rvi007/welding-robot/docs/images/closeup.png

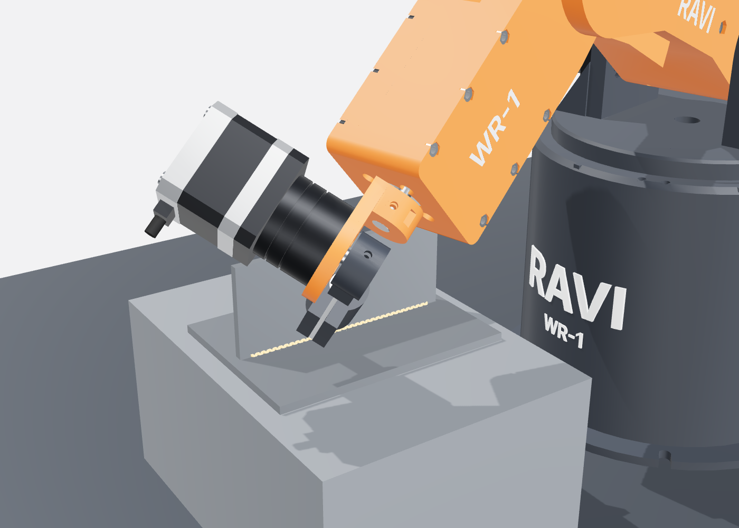
docs/images/closeup.png
