rvi007/welding-robot/docs/images/fillet_straight.png

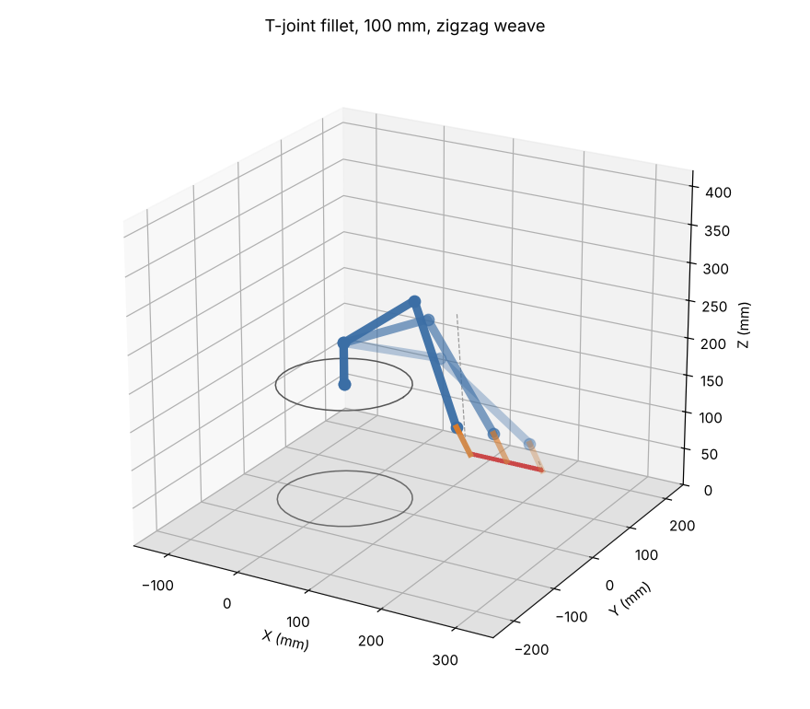
docs/images/fillet_straight.png
