rvi007/welding-robot/docs/images/front.png

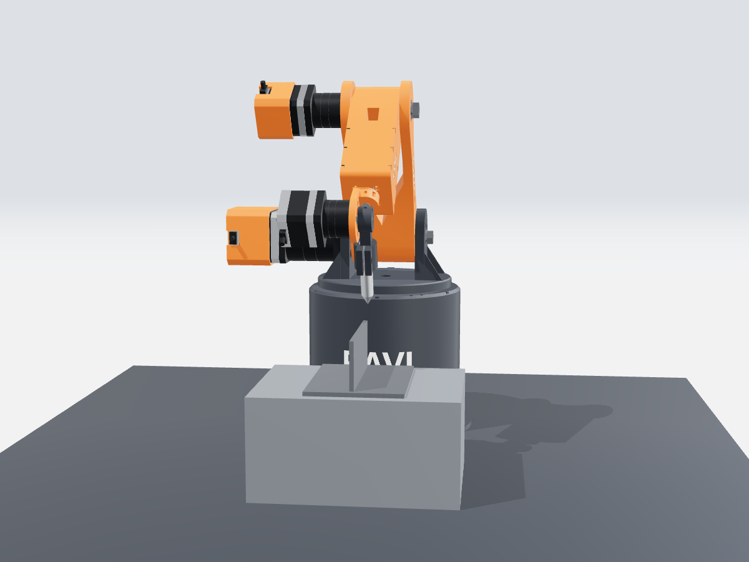
docs/images/front.png
