rvi007/welding-robot/docs/images/ready.png

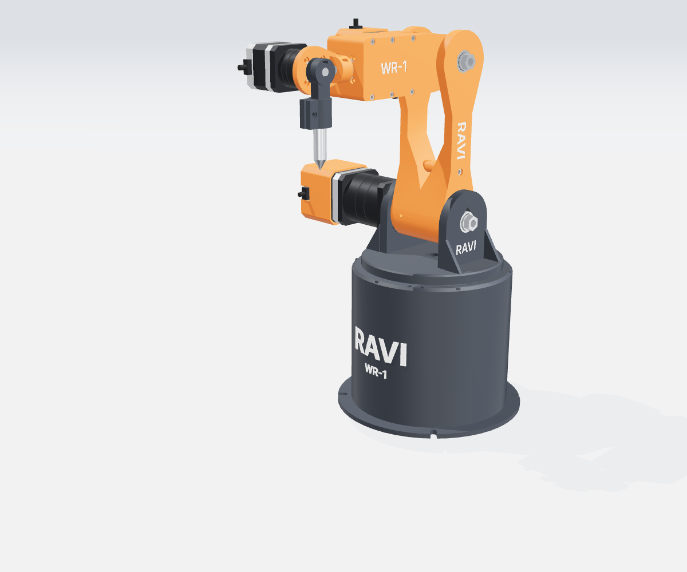
docs/images/ready.png
