rvi007/welding-robot/docs/images/side.png

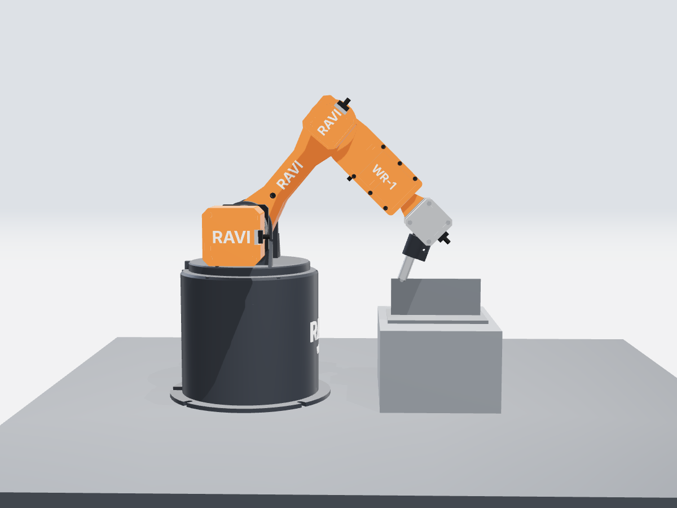
docs/images/side.png
