rvi007/welding-robot/docs/bom.csv

category | qty | part | used_for | approx_usd
motion | 2 | NEMA17 48mm 1.68A stepper + 26.85:1 planetary gearbox, 8mm D-shaft (e.g. StepperOnline 17HS19-1684S-PG27) | J1 base, J3 elbow | 70
motion | 2 | NEMA17 34mm stepper + 5.18:1 planetary gearbox, 8mm D-shaft (e.g. StepperOnline 17HS13-0404S-PG5) | J4 roll, J5 wrist | 55
motion | 1 | NEMA23 56mm 2.8A stepper + 10:1 planetary gearbox, 14mm keyed shaft, bought as one unit | J2 shoulder | 80
motion | 2 | 6008-2RS bearing 40x68x15 | J1 turntable | 10
motion | 4 | 608-2RS bearing 8x22x7 | J2/J3 idle pivots (2 spare) | 4
electronics | 1 | Arduino Mega 2560 | controller | 18
electronics | 1 | RAMPS 1.4 | controller shield | 8
electronics | 4 | TMC2209 step/dir driver | J1, J3, J4, J5 | 20
electronics | 1 | DM542T stepper driver | J2 | 30
electronics | 1 | 12V 15A power supply | RAMPS | 25
electronics | 1 | 24-36V 5A power supply | DM542T | 22
electronics | 5 | KW11 / SS-5GL lever microswitch | homing | 6
electronics | 1 | 12V relay module | arc output (D10) | 4
electronics | 1 | Mushroom E-stop, 2x NC | safety | 10
electronics | 1 | Mains inlet with switch and fuse | power | 6
electronics | 1 | Cables, ferrites, connectors, spiral wrap | wiring | 30
hardware | 20 | M3 heat-set insert | printed parts | 8
hardware | 1 | Screw kit: M2, M3, M4, M5 button/socket/countersunk, M8x50, M8x45, nuts, washers, set screws | assembly | 25
printing | 1 | PETG filament 1kg orange | arm, covers | 20
printing | 1 | PETG filament 1kg graphite/black | base, turntable, small parts | 20
printing | 1 | White paint pen | RAVI lettering | 4
tool | 1 | 12mm pointer rod or laser module | calibration | 5
tool | 1 | Marker refill + 12mm sleeve | pen tests | 2
