rvi007/welding-robot/docs/images/parts/upper_arm_drive.png

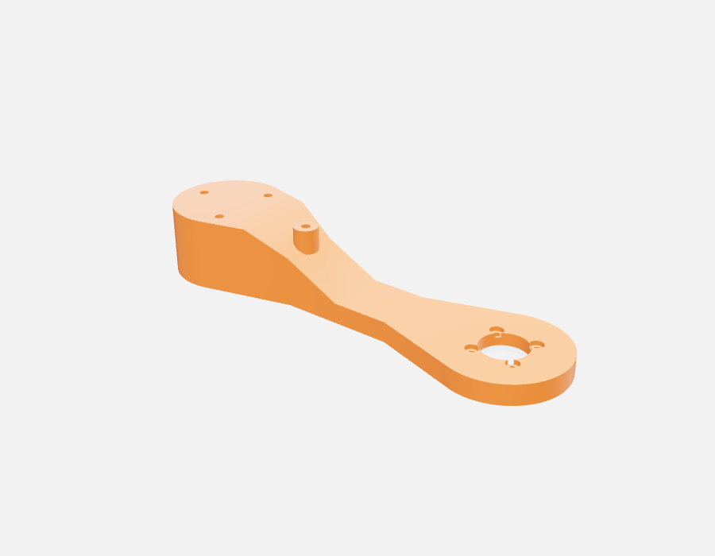
docs/images/parts/upper_arm_drive.png
