rvi007/welding-robot/docs/viewer/models/L1_black.stl

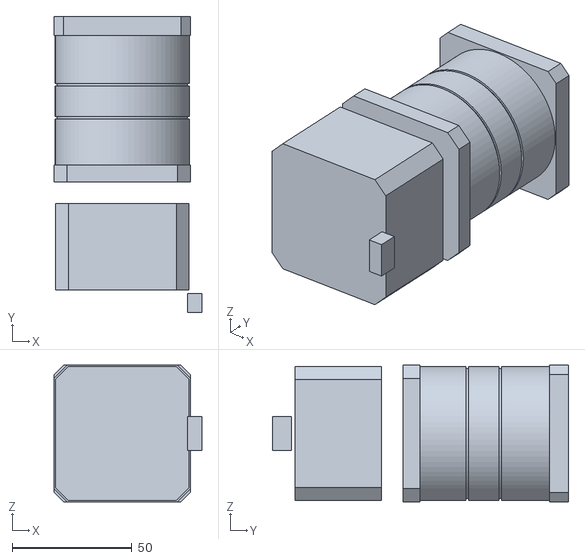
[picture p29: CAD file, 2026-10-21]
docs/viewer/models/L1_black.stl
61.7 x 123.5 x 57.0
