rvi007/welding-robot/docs/viewer/models/C_gm17_34_logo.stl

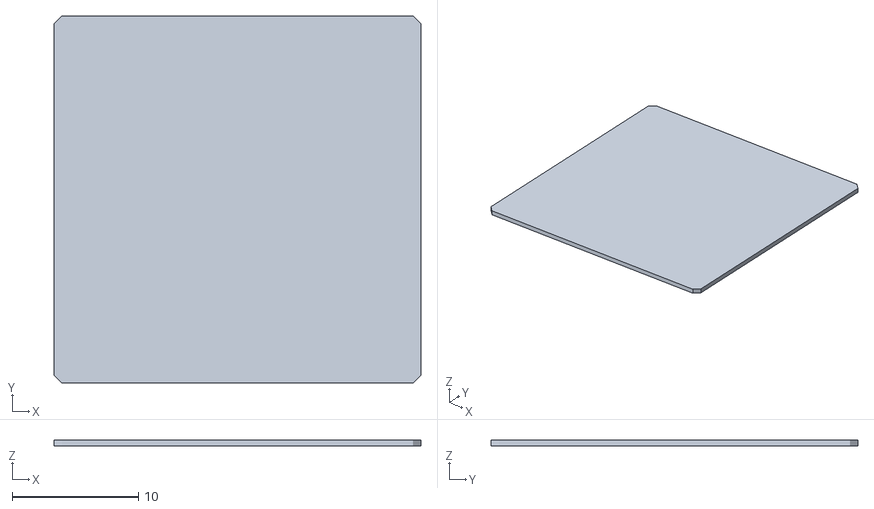
[picture p31: CAD file, 2026-10-21]
docs/viewer/models/C_gm17_34_logo.stl
29.1 x 29.1 x 0.5
