rvi007/welding-robot/stl/j1_motor_mount.stl

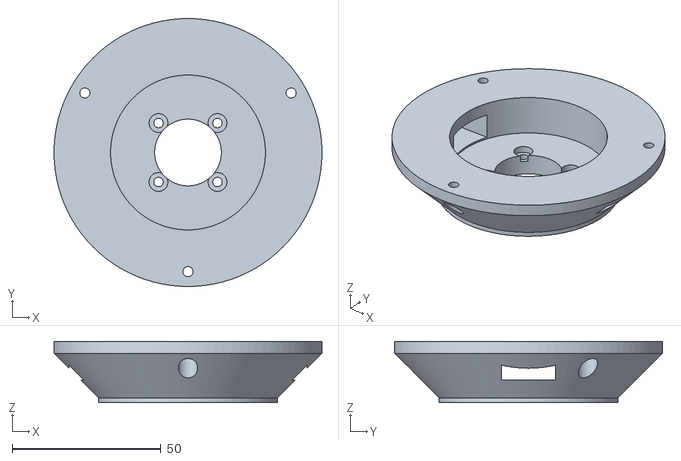
[picture p32: CAD file, 2026-10-21]
stl/j1_motor_mount.stl
90.0 x 90.0 x 20.5
