rvi007/welding-robot/docs/viewer/models/C_gm23_56_steel.stl

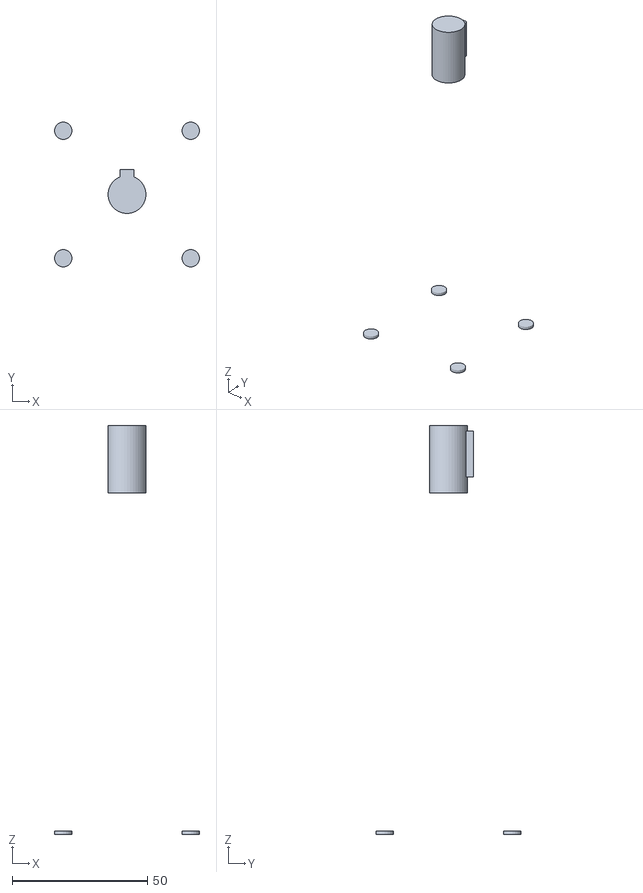
[picture p33: CAD file, 2026-10-21]
docs/viewer/models/C_gm23_56_steel.stl
53.6 x 53.6 x 151.2
