rvi007/welding-robot/stl/j1_collar.stl

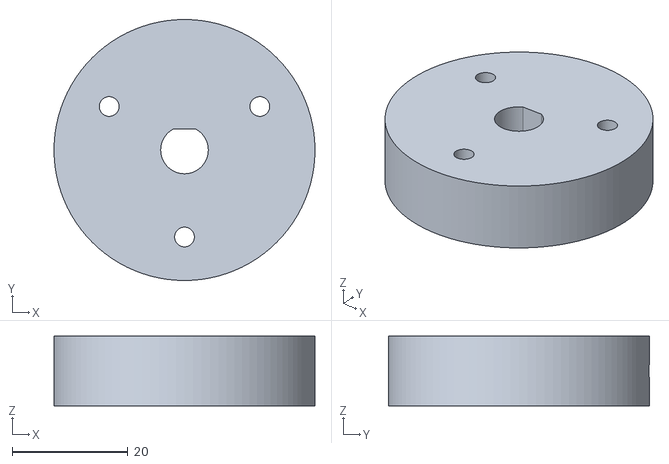
[picture p34: CAD file, 2026-10-21]
stl/j1_collar.stl
45.0 x 45.0 x 12.0
