rvi007/welding-robot/docs/viewer/models/L4_alu.stl

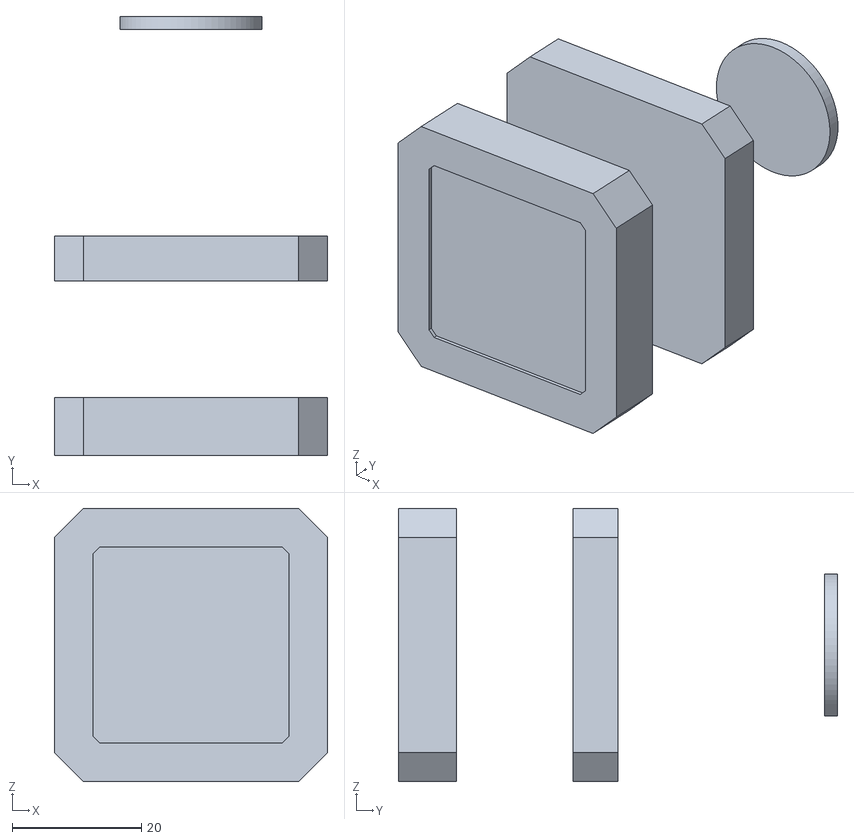
[picture p35: CAD file, 2026-10-21]
docs/viewer/models/L4_alu.stl
42.3 x 68.0 x 42.3
