rvi007/welding-robot/stl/wrist.stl

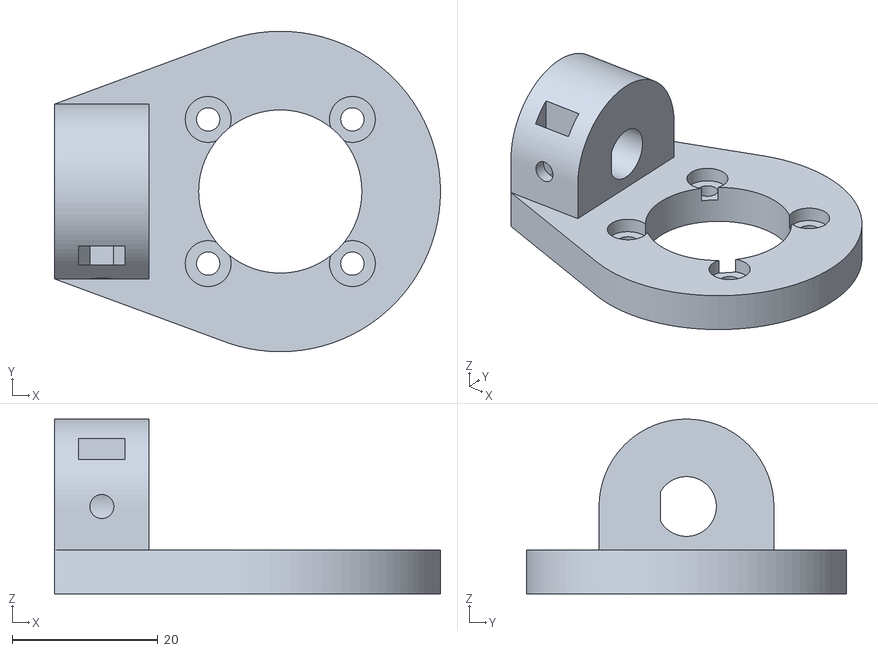
[picture p36: CAD file, 2026-10-21]
stl/wrist.stl
53.0 x 44.0 x 24.0
