rvi007/welding-robot/docs/viewer/models/C_gm17_48_rubber.stl

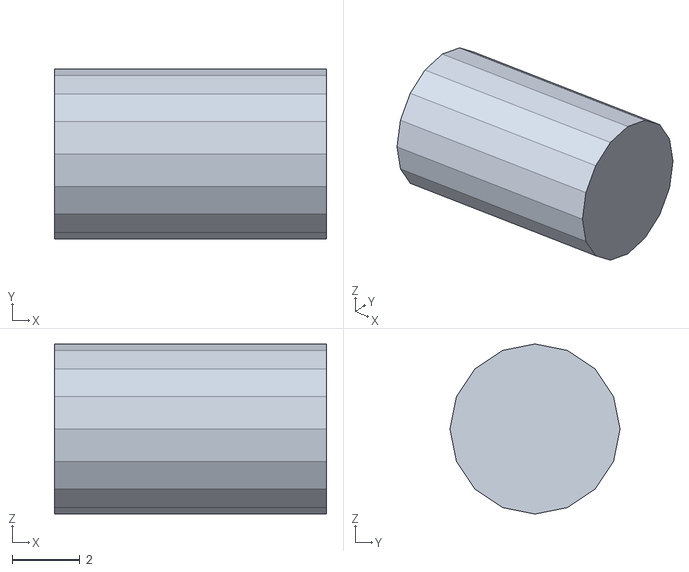
[picture p37: CAD file, 2026-10-21]
docs/viewer/models/C_gm17_48_rubber.stl
8.00 x 5.00 x 5.00
