rvi007/welding-robot/stl/j2_cover.stl

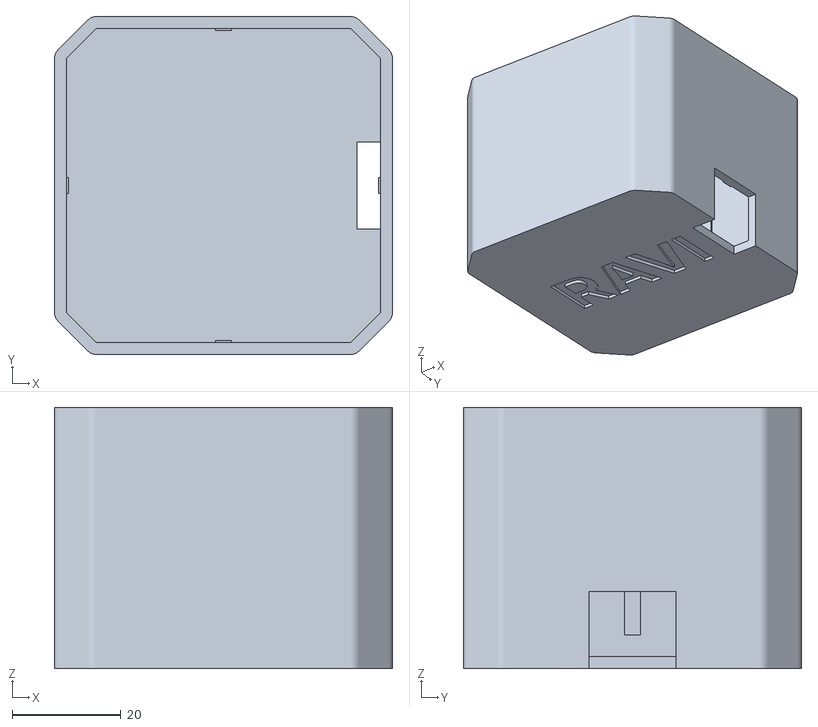
[picture p38: CAD file, 2026-10-21]
stl/j2_cover.stl
62.1 x 62.1 x 48.0
