rvi007/welding-robot/docs/viewer/models/L6_table.stl

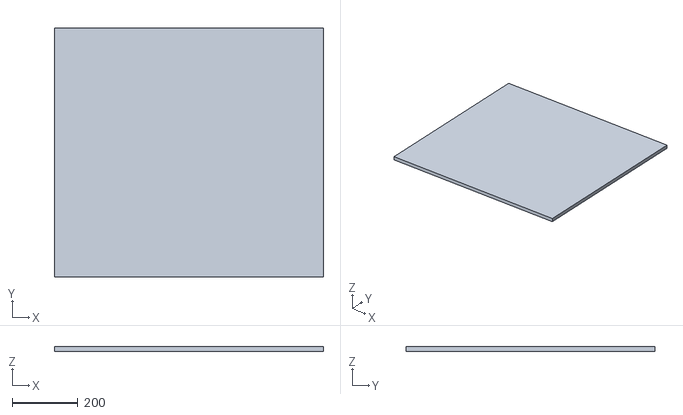
[picture p39: CAD file, 2026-10-21]
docs/viewer/models/L6_table.stl
820.0 x 760.0 x 15.0
