rvi007/welding-robot/stl/endstop_clip.stl

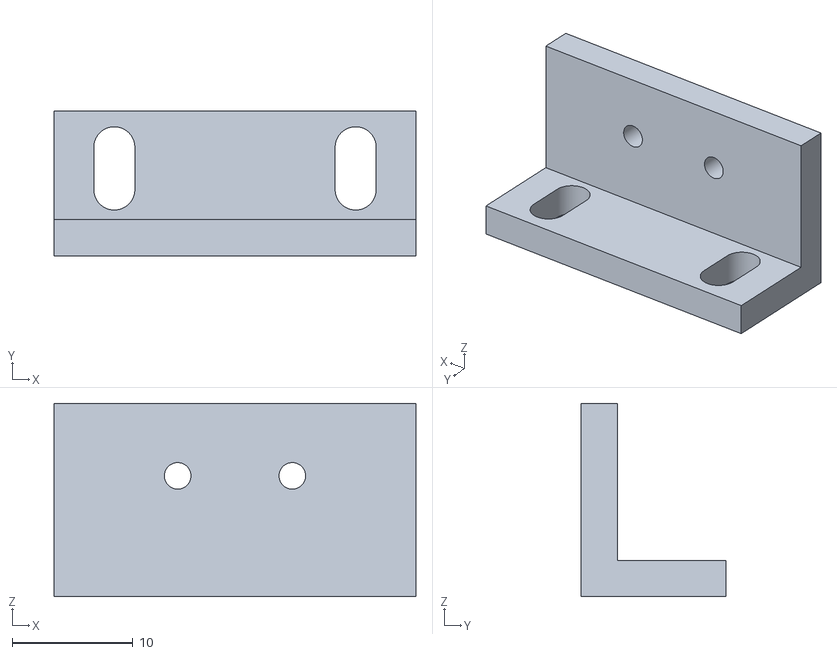
[picture p40: CAD file, 2026-10-21]
stl/endstop_clip.stl
30.0 x 12.0 x 16.0
