rvi007/welding-robot/docs/viewer/models/L5_printed2.stl

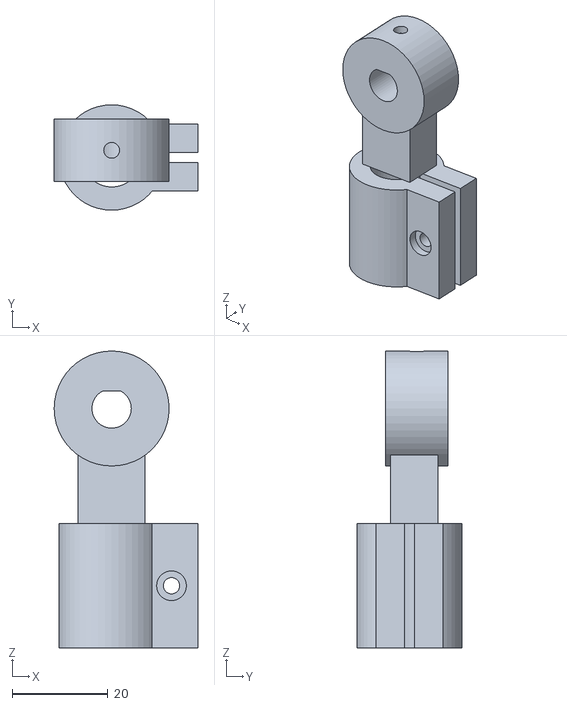
[picture p41: CAD file, 2026-10-21]
docs/viewer/models/L5_printed2.stl
30.0 x 22.0 x 62.0
