rvi007/welding-robot/stl/base_shell.stl

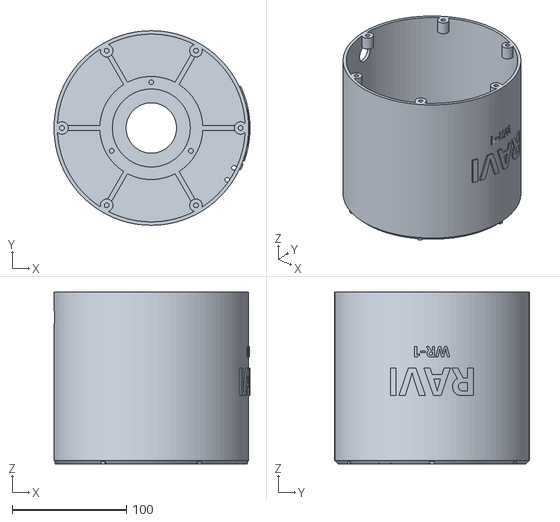
[picture p42: CAD file, 2026-10-21]
stl/base_shell.stl
171.2 x 170.0 x 150.0
