rvi007/welding-robot/stl/upper_arm_drive.stl

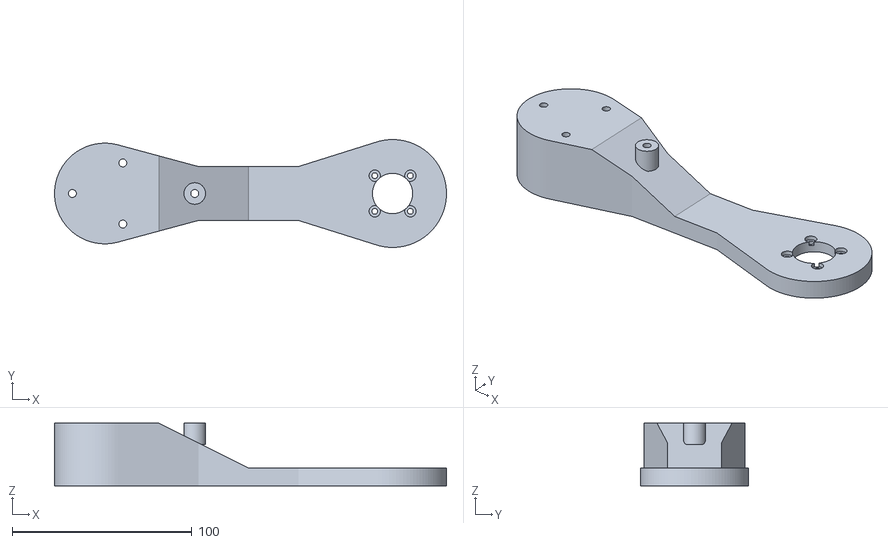
[picture p43: CAD file, 2026-10-21]
stl/upper_arm_drive.stl
218.0 x 60.0 x 35.0
