rvi007/welding-robot/docs/viewer/models/L0_rubber.stl

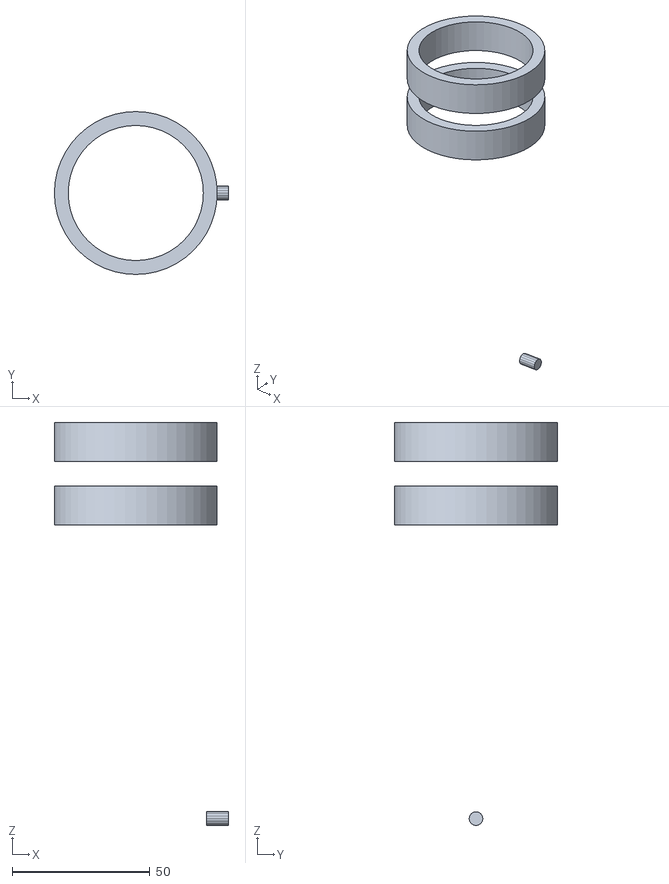
[picture p44: CAD file, 2026-10-21]
docs/viewer/models/L0_rubber.stl
63.2 x 59.0 x 146.1
