rvi007/welding-robot/stl/j3_cover.stl

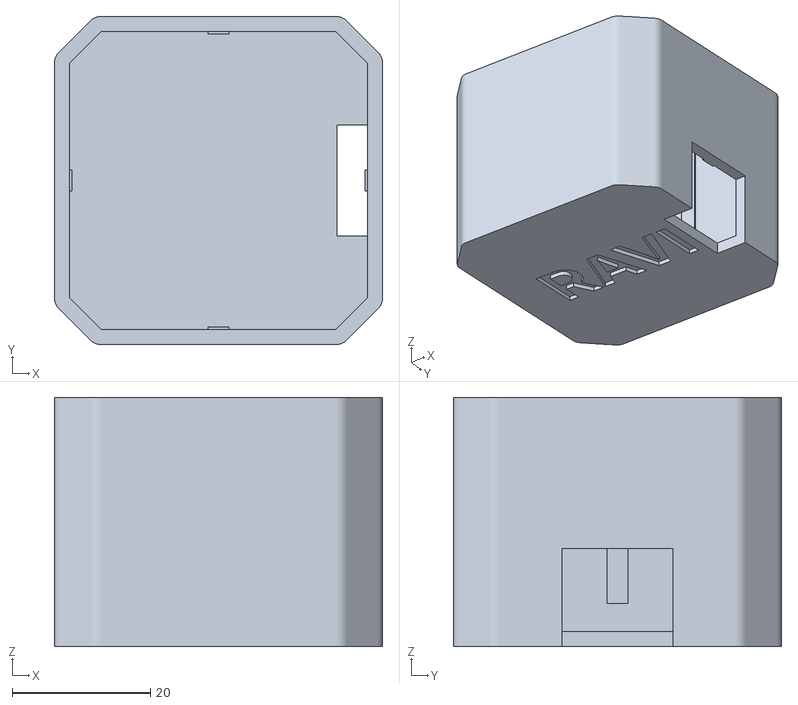
[picture p45: CAD file, 2026-10-21]
stl/j3_cover.stl
47.4 x 47.4 x 36.0
