rvi007/welding-robot/docs/viewer/models/L1_steel.stl

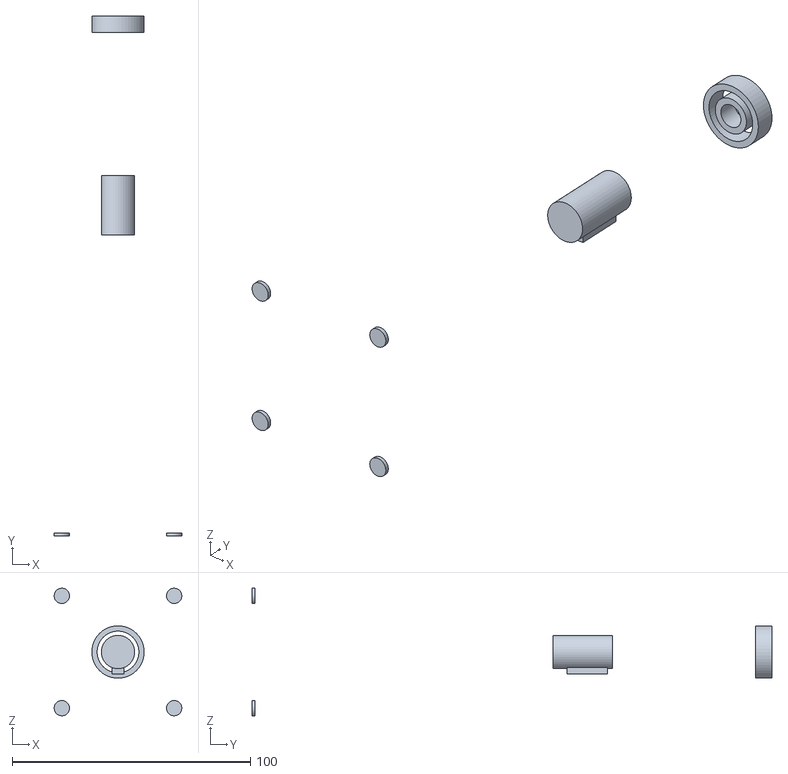
[picture p46: CAD file, 2026-10-21]
docs/viewer/models/L1_steel.stl
53.6 x 218.2 x 53.6
