rvi007/welding-robot/stl/turntable.stl

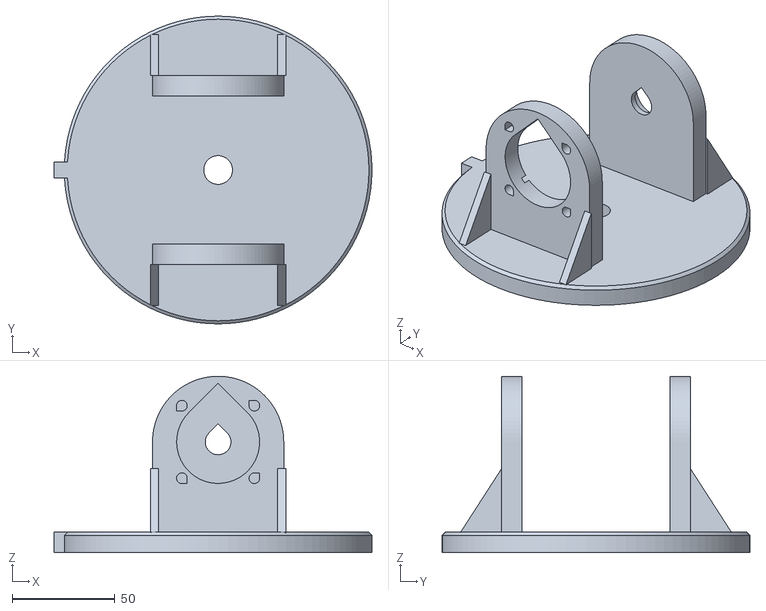
[picture p47: CAD file, 2026-10-21]
stl/turntable.stl
155.0 x 150.0 x 86.0
