rvi007/welding-robot/docs/viewer/models/C_b6008_steel.stl

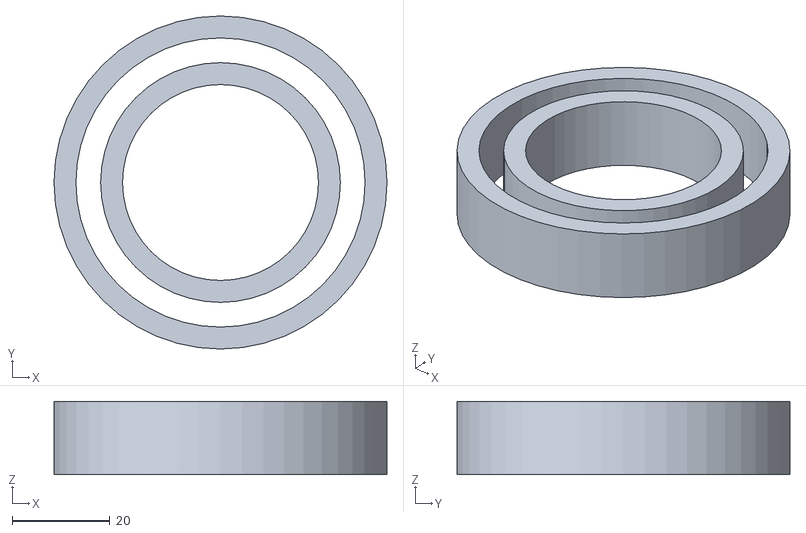
[picture p48: CAD file, 2026-10-21]
docs/viewer/models/C_b6008_steel.stl
68.0 x 68.0 x 15.0
