rvi007/welding-robot/stl/j1_spigot.stl

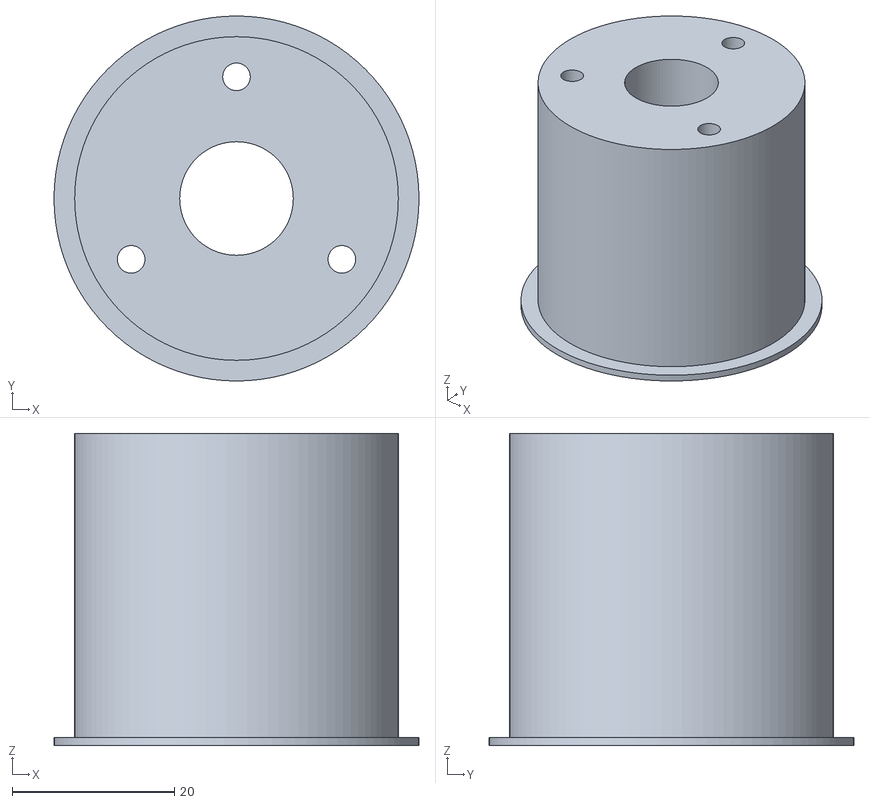
[picture p49: CAD file, 2026-10-21]
stl/j1_spigot.stl
45.0 x 45.0 x 38.5
