rvi007/welding-robot/stl/base_floor.stl

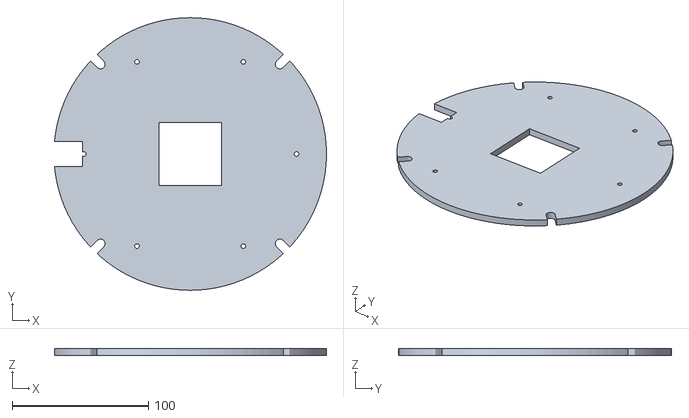
[picture p50: CAD file, 2026-10-21]
stl/base_floor.stl
199.5 x 200.0 x 5.00
