rvi007/welding-robot/stl/fit_test.stl

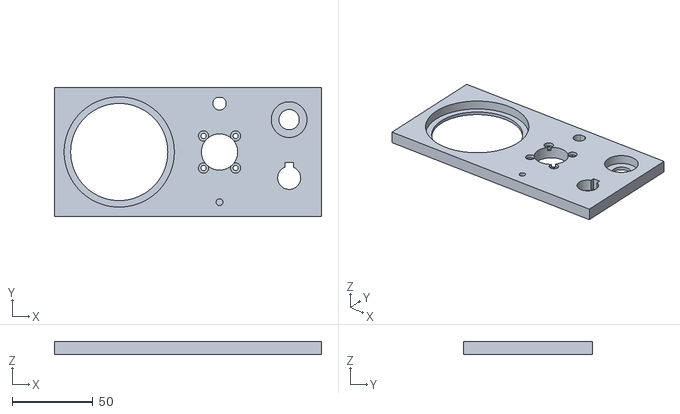
[picture p51: CAD file, 2026-10-21]
stl/fit_test.stl
165.0 x 80.0 x 8.00
