rvi007/welding-robot/docs/viewer/models/L3_printed.stl

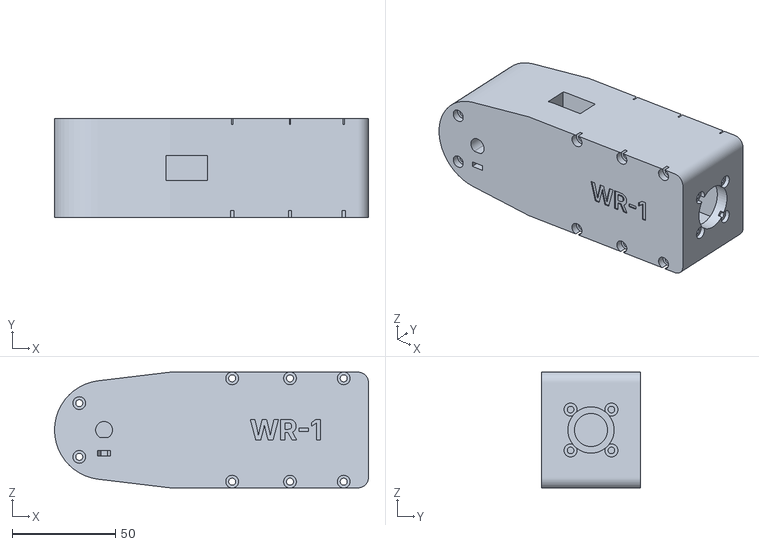
[picture p52: CAD file, 2026-10-21]
docs/viewer/models/L3_printed.stl
152.0 x 48.0 x 56.0
