rvi007/welding-robot/docs/viewer/models/L0_alu.stl

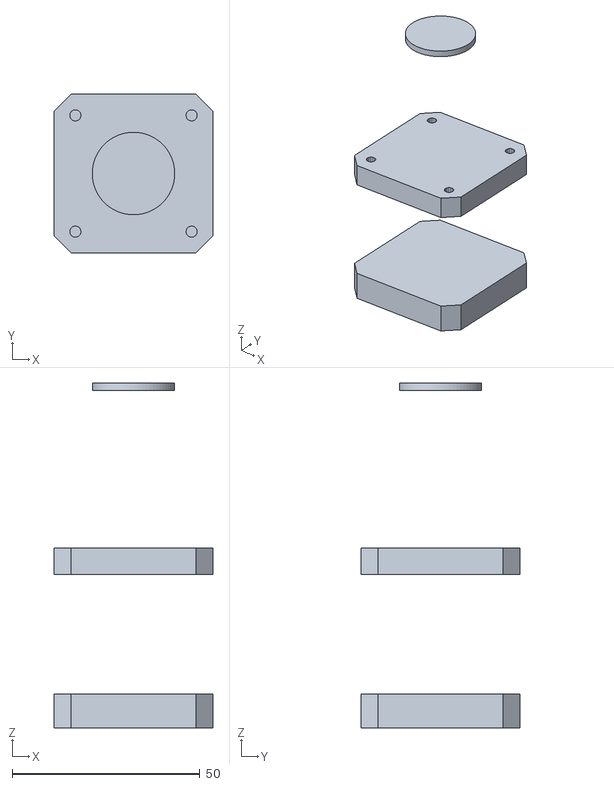
[picture p53: CAD file, 2026-10-21]
docs/viewer/models/L0_alu.stl
42.3 x 42.3 x 92.0
