rvi007/welding-robot/stl/forearm_drive.stl

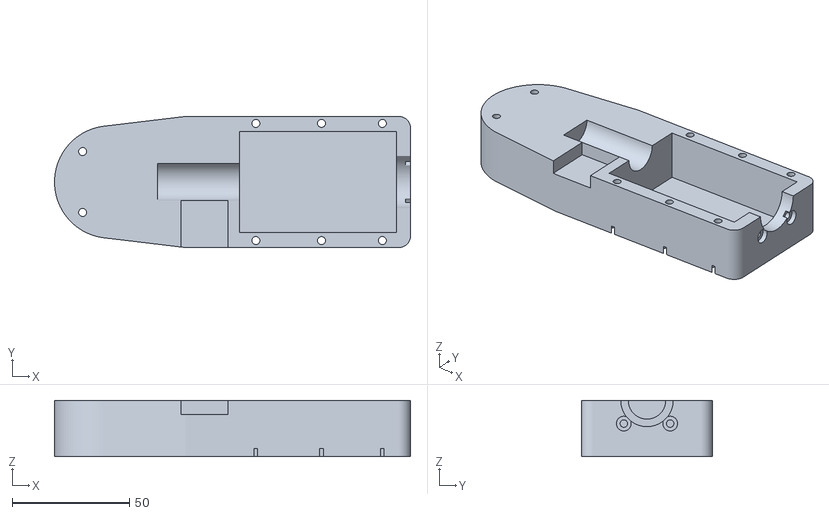
[picture p54: CAD file, 2026-10-21]
stl/forearm_drive.stl
152.0 x 56.0 x 24.0
