rvi007/welding-robot/docs/viewer/models/C_gm17_34_steel.stl

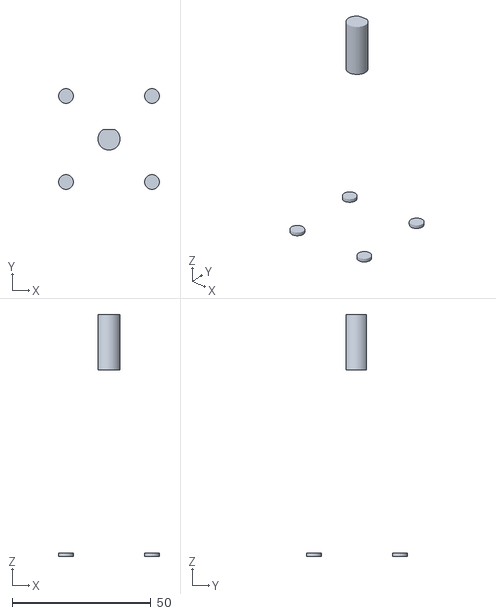
[picture p55: CAD file, 2026-10-21]
docs/viewer/models/C_gm17_34_steel.stl
36.4 x 36.4 x 87.2
