rvi007/welding-robot/docs/viewer/models/C_gm23_56_logo.stl

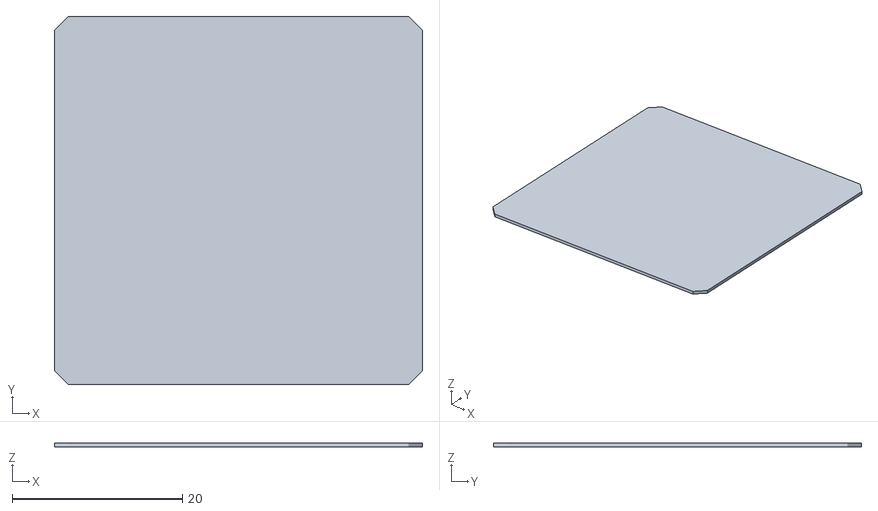
[picture p56: CAD file, 2026-10-21]
docs/viewer/models/C_gm23_56_logo.stl
43.2 x 43.2 x 0.5
