rvi007/welding-robot/stl/spacer_m8.stl

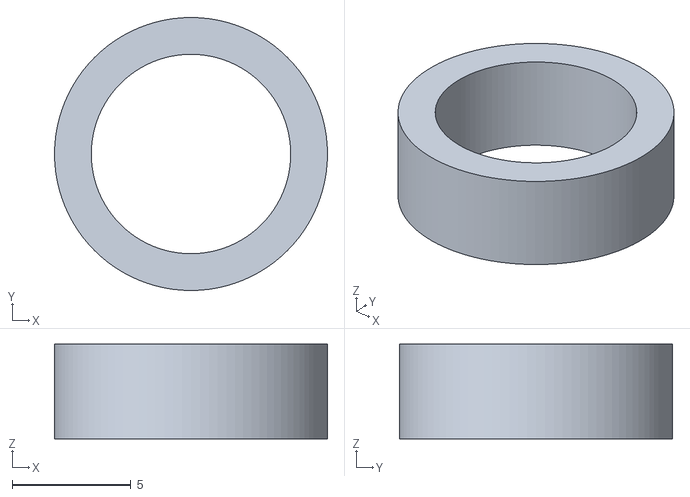
[picture p57: CAD file, 2026-10-21]
stl/spacer_m8.stl
11.5 x 11.5 x 4.00
