rvi007/welding-robot/docs/viewer/models/L3_black.stl

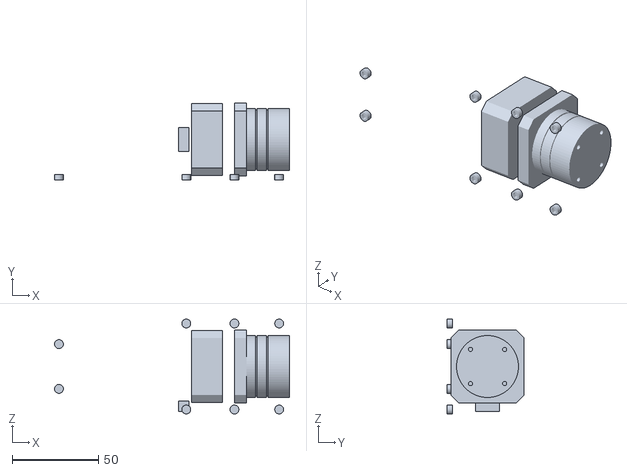
[picture p58: CAD file, 2026-10-21]
docs/viewer/models/L3_black.stl
136.6 x 44.6 x 55.2
