rvi007/welding-robot/docs/viewer/models/L2_steel.stl

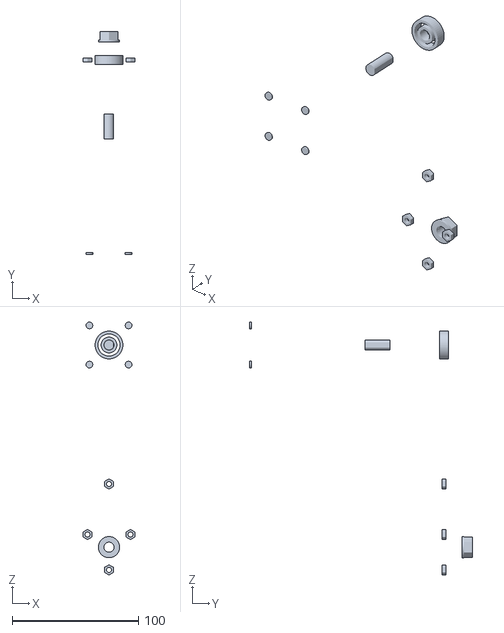
[picture p59: CAD file, 2026-10-21]
docs/viewer/models/L2_steel.stl
41.0 x 176.2 x 200.2
