rvi007/welding-robot/docs/viewer/models/L4_black.stl

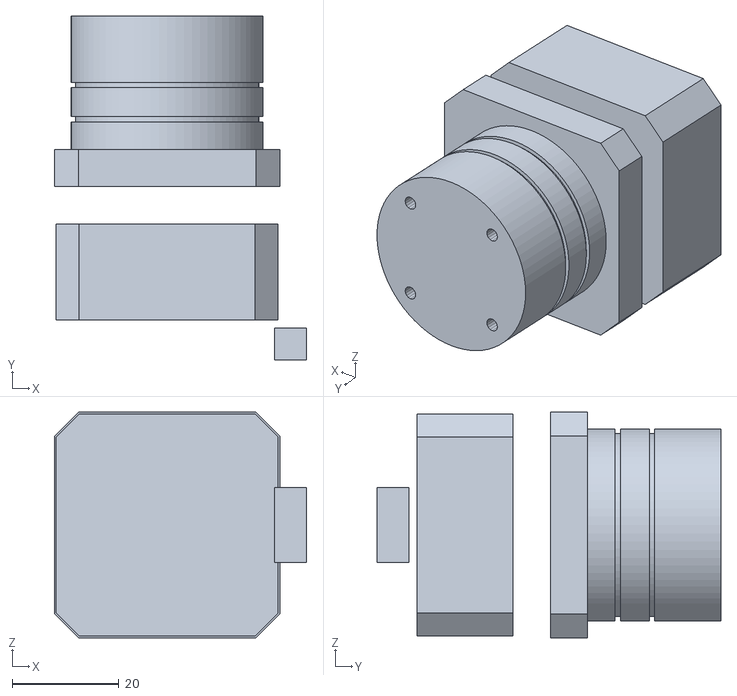
[picture p60: CAD file, 2026-10-21]
docs/viewer/models/L4_black.stl
47.3 x 64.5 x 42.3
