rvi007/welding-robot/docs/viewer/models/L1_logo.stl

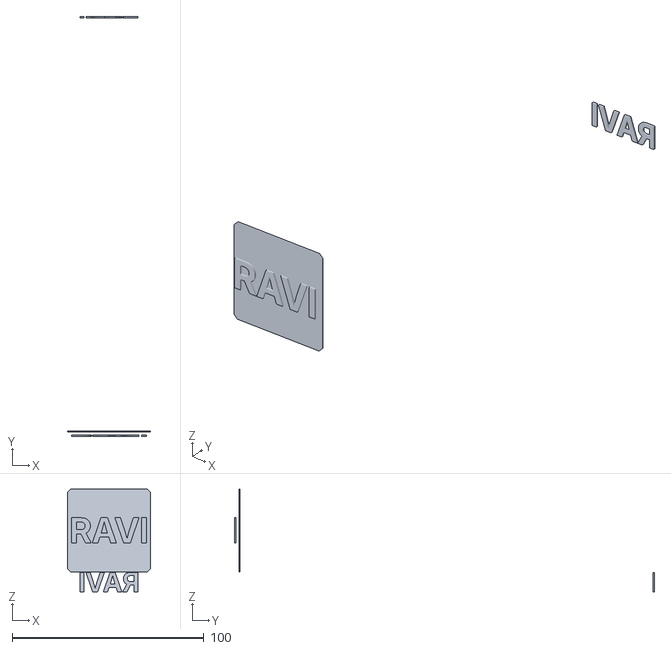
[picture p61: CAD file, 2026-10-21]
docs/viewer/models/L1_logo.stl
43.2 x 219.2 x 53.5
