rvi007/welding-robot/docs/viewer/models/C_gm23_56_alu.stl

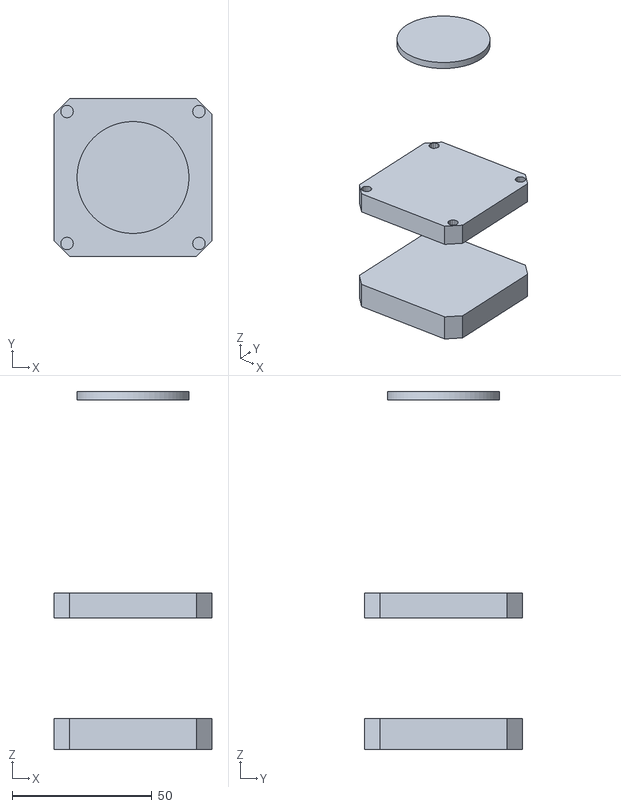
[picture p62: CAD file, 2026-10-21]
docs/viewer/models/C_gm23_56_alu.stl
56.4 x 56.4 x 128.0
