rvi007/welding-robot/docs/viewer/models/C_b608_steel.stl

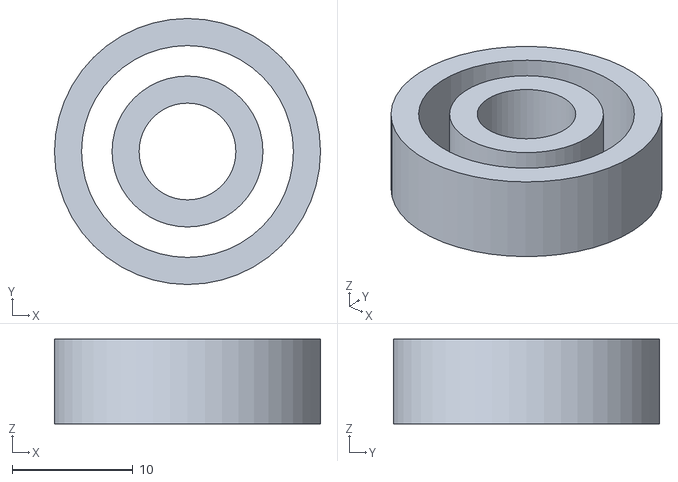
[picture p63: CAD file, 2026-10-21]
docs/viewer/models/C_b608_steel.stl
22.0 x 22.0 x 7.00
