rvi007/welding-robot/docs/viewer/models/L3_logo.stl

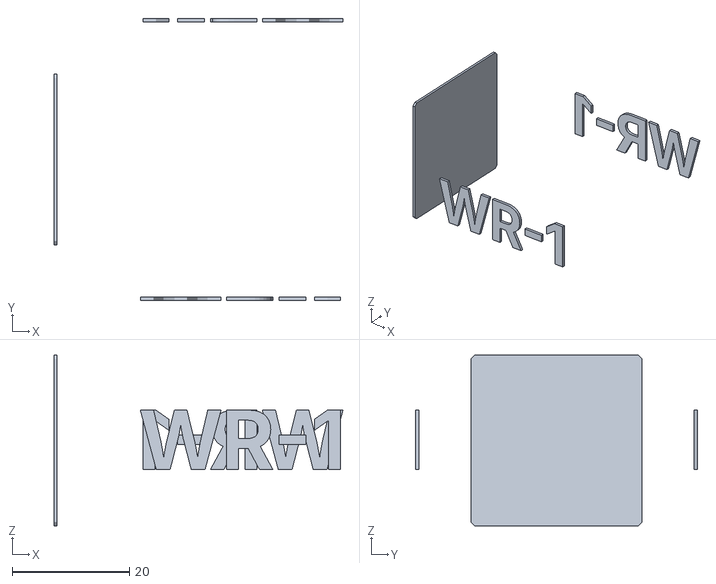
[picture p64: CAD file, 2026-10-21]
docs/viewer/models/L3_logo.stl
49.2 x 48.0 x 29.1
