rvi007/welding-robot/docs/viewer/models/L3_steel.stl

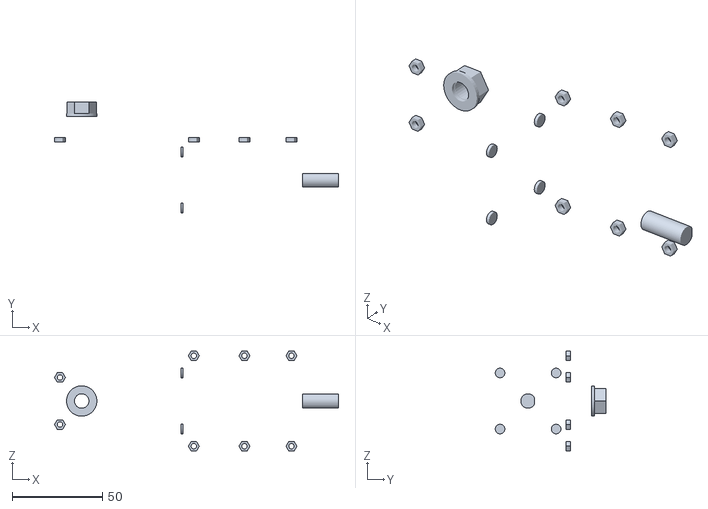
[picture p65: CAD file, 2026-10-21]
docs/viewer/models/L3_steel.stl
157.0 x 61.2 x 55.2
