rvi007/welding-robot/docs/viewer/models/C_gm17_48_black.stl

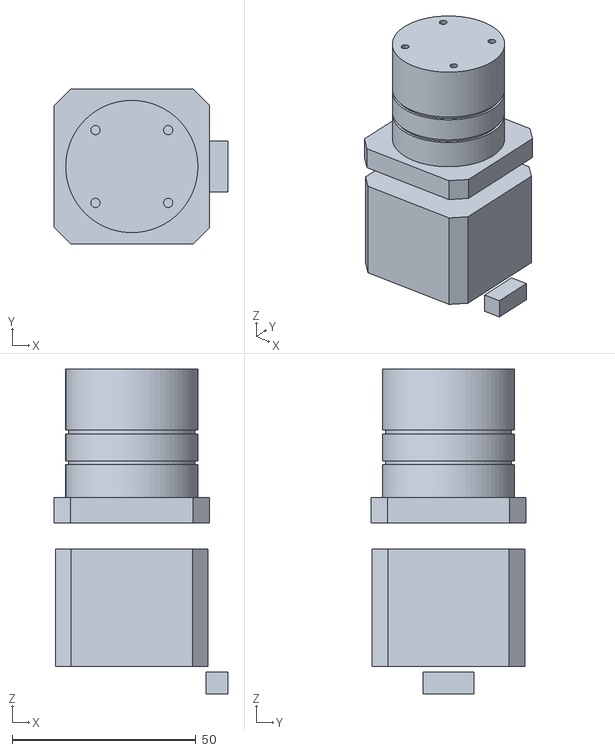
[picture p66: CAD file, 2026-10-21]
docs/viewer/models/C_gm17_48_black.stl
47.3 x 42.3 x 88.5
