rvi007/welding-robot/docs/viewer/models/L6_coupon.stl

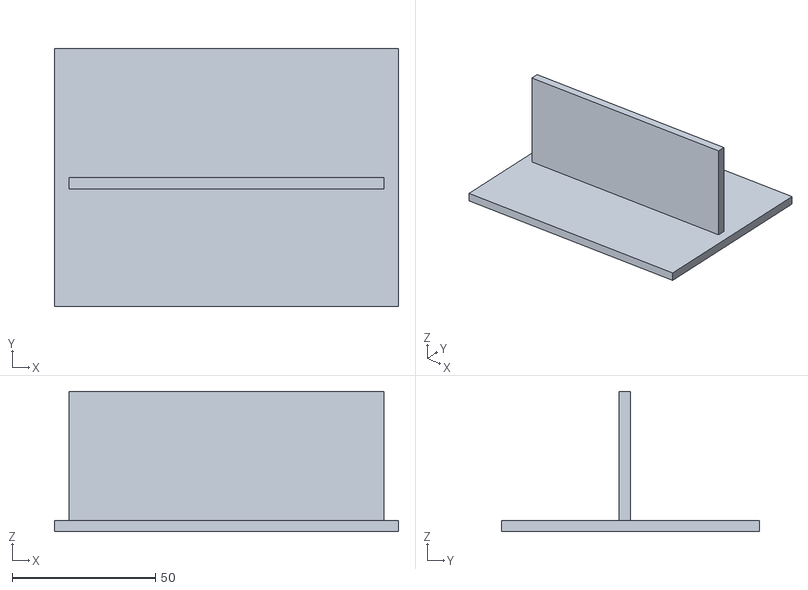
[picture p67: CAD file, 2026-10-21]
docs/viewer/models/L6_coupon.stl
120.0 x 90.0 x 49.0
