rvi007/welding-robot/docs/viewer/models/L2_black.stl

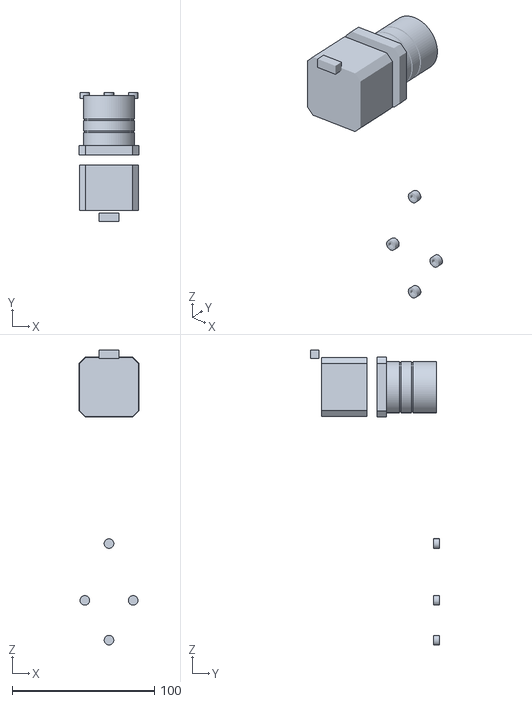
[picture p68: CAD file, 2026-10-21]
docs/viewer/models/L2_black.stl
42.3 x 90.5 x 207.5
