rvi007/welding-robot/docs/viewer/models/L2_logo.stl

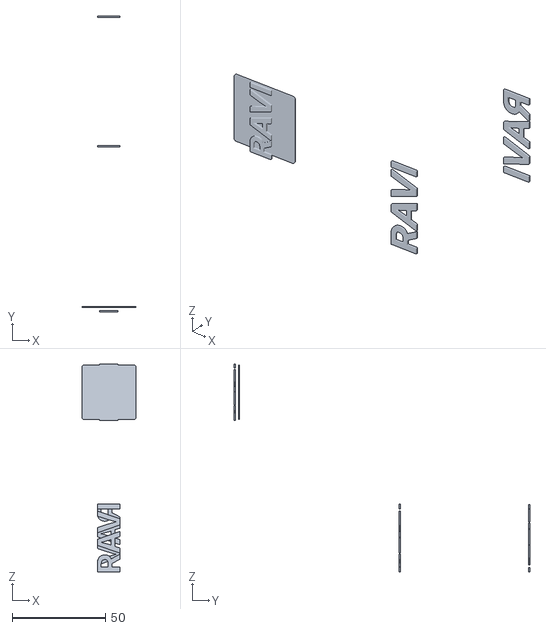
[picture p69: CAD file, 2026-10-21]
docs/viewer/models/L2_logo.stl
29.1 x 158.2 x 111.3
