rvi007/welding-robot/docs/viewer/models/L5_alu.stl

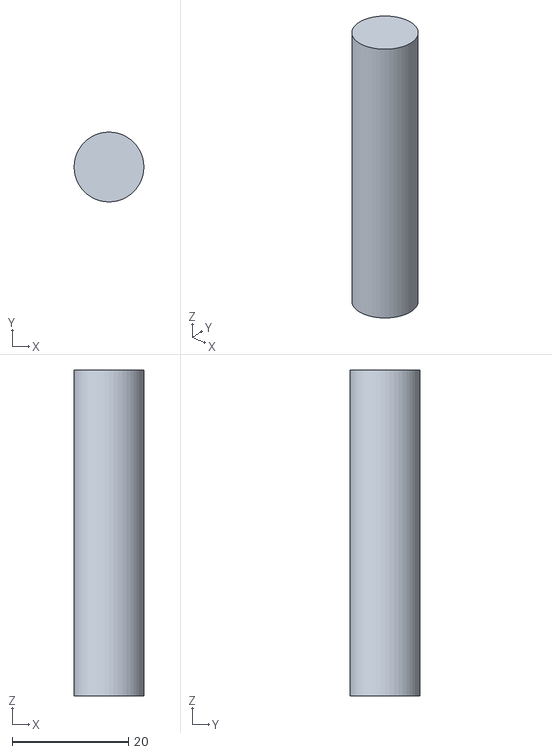
[picture p70: CAD file, 2026-10-21]
docs/viewer/models/L5_alu.stl
12.0 x 12.0 x 56.0
