rvi007/welding-robot/docs/viewer/models/L5_steel.stl

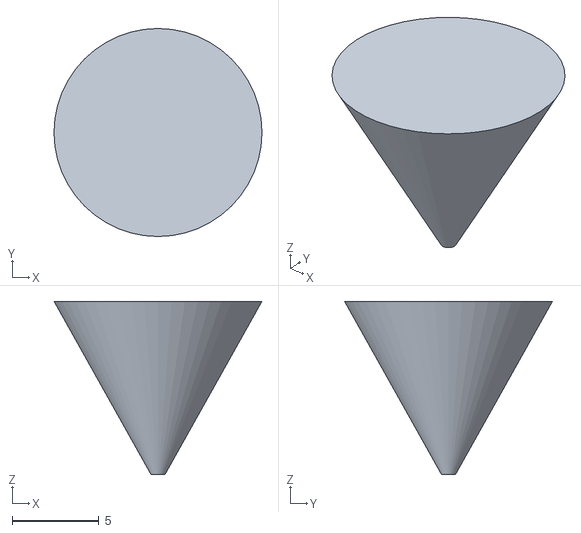
[picture p71: CAD file, 2026-10-21]
docs/viewer/models/L5_steel.stl
12.0 x 12.0 x 10.0
