rvi007/welding-robot/docs/viewer/models/L2_printed.stl

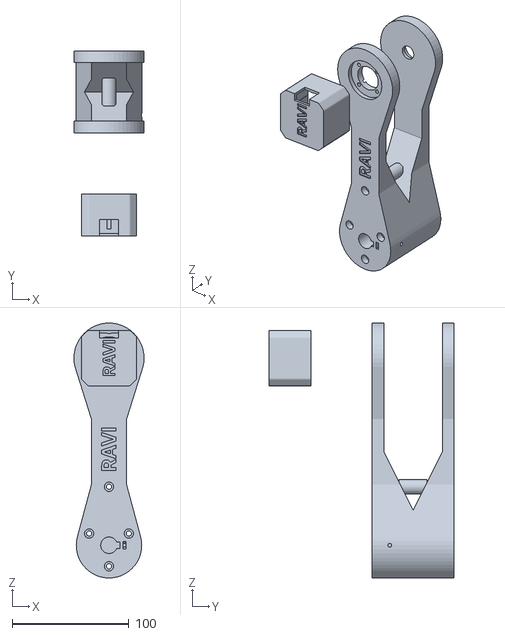
[picture p72: CAD file, 2026-10-21]
docs/viewer/models/L2_printed.stl
60.0 x 158.2 x 218.0
