rvi007/welding-robot/docs/viewer/models/C_b6008_rubber.stl

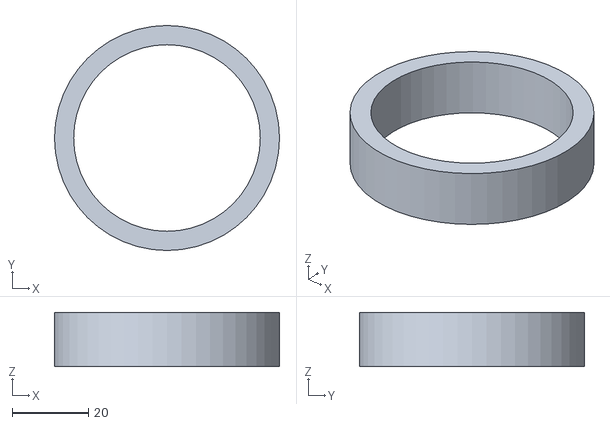
[picture p73: CAD file, 2026-10-21]
docs/viewer/models/C_b6008_rubber.stl
59.0 x 59.0 x 14.2
