rvi007/welding-robot/docs/viewer/models/L0_logo.stl

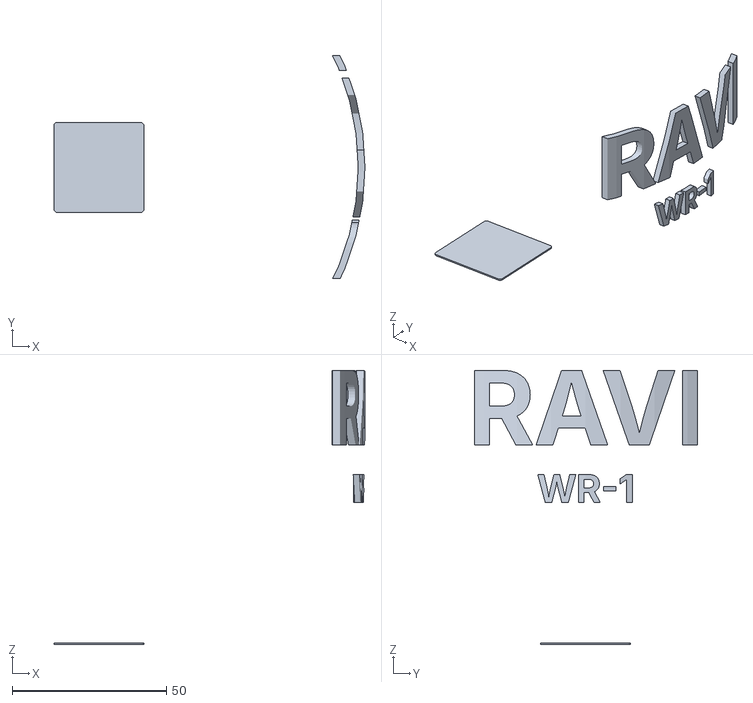
[picture p74: CAD file, 2026-10-21]
docs/viewer/models/L0_logo.stl
100.7 x 72.4 x 88.9
