rvi007/welding-robot/docs/viewer/models/C_b608_rubber.stl

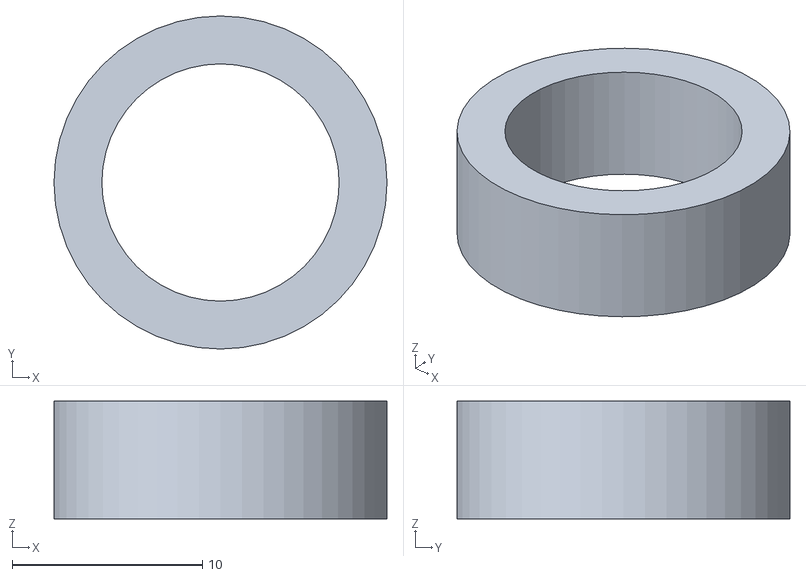
[picture p75: CAD file, 2026-10-21]
docs/viewer/models/C_b608_rubber.stl
17.5 x 17.5 x 6.20
