rvi007/welding-robot/docs/viewer/models/L6_block.stl

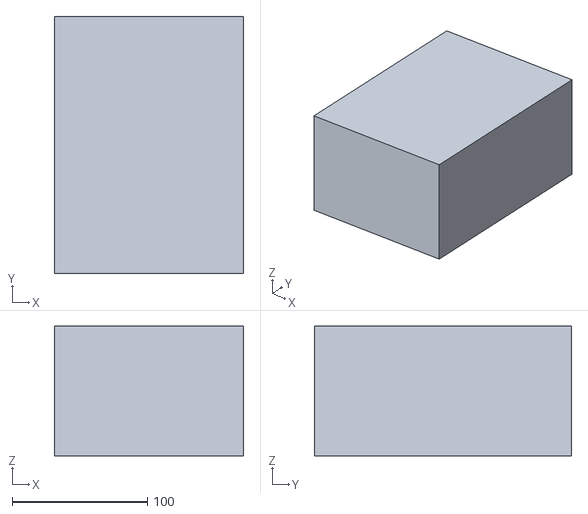
[picture p76: CAD file, 2026-10-21]
docs/viewer/models/L6_block.stl
140.0 x 190.0 x 96.0
