rvi007/welding-robot/docs/viewer/models/C_gm17_48_steel.stl

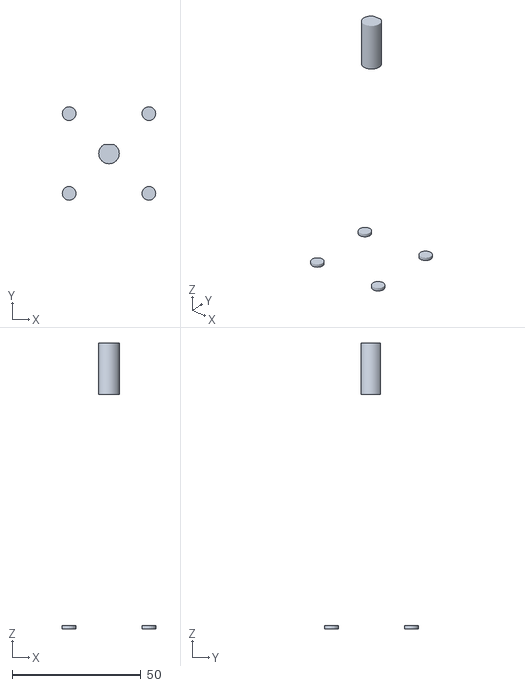
[picture p77: CAD file, 2026-10-21]
docs/viewer/models/C_gm17_48_steel.stl
36.4 x 36.4 x 111.2
