rvi007/welding-robot/docs/viewer/models/L0_steel.stl

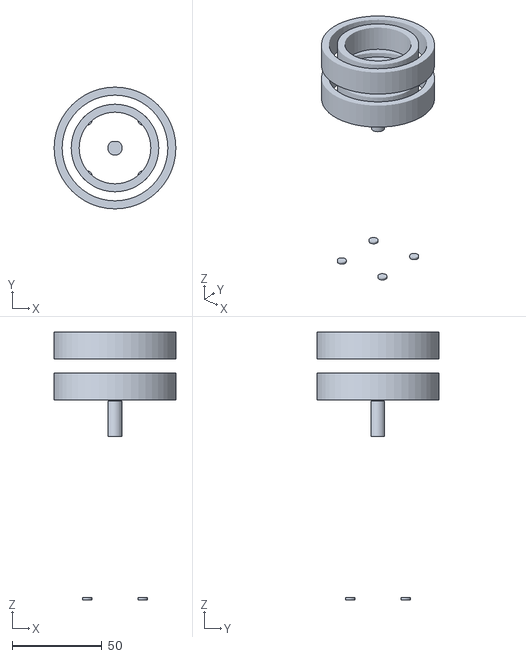
[picture p78: CAD file, 2026-10-21]
docs/viewer/models/L0_steel.stl
68.0 x 68.0 x 149.7
