rvi007/welding-robot/docs/viewer/models/L1_rubber.stl

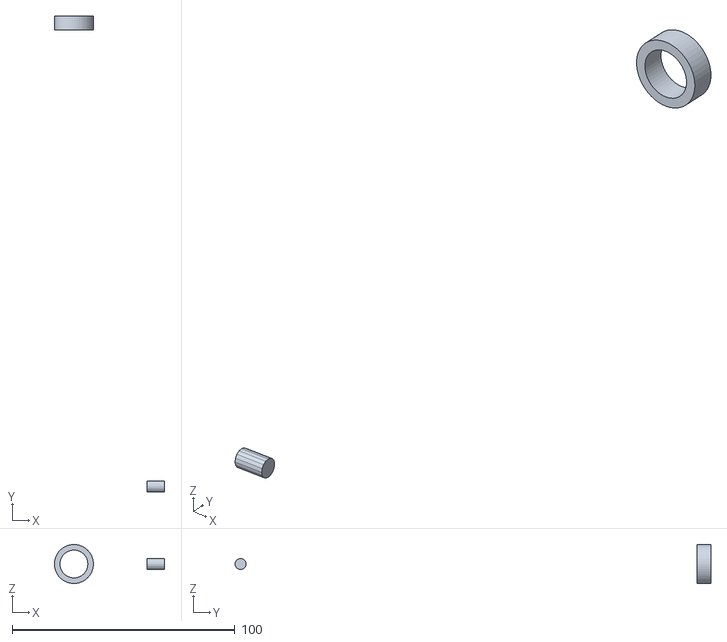
[picture p79: CAD file, 2026-10-21]
docs/viewer/models/L1_rubber.stl
49.5 x 213.6 x 17.5
