rvi007/welding-robot/docs/viewer/models/L0_printed2.stl

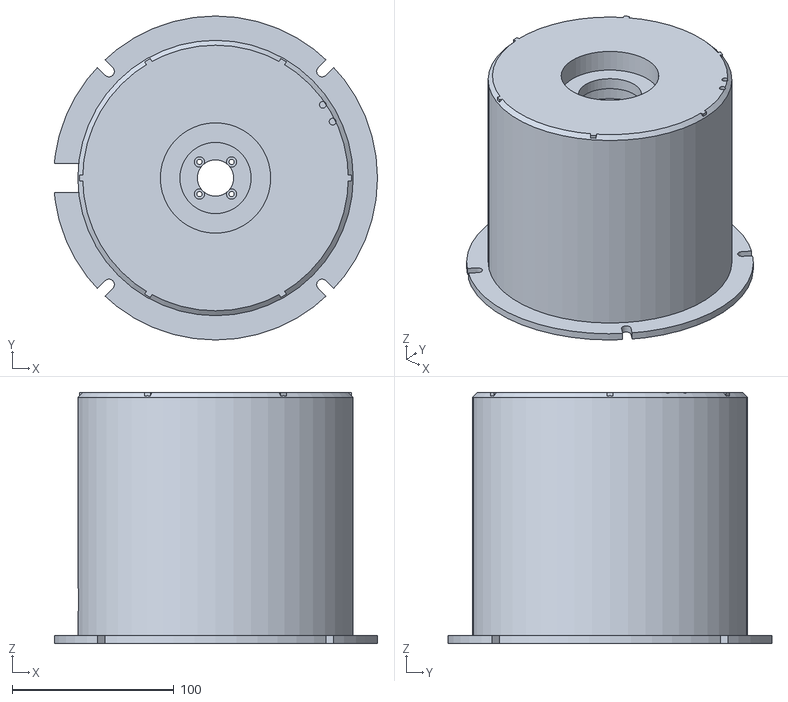
[picture p80: CAD file, 2026-10-21]
docs/viewer/models/L0_printed2.stl
199.4 x 200.0 x 155.0
