rvi007/welding-robot/docs/viewer/models/L2_rubber.stl

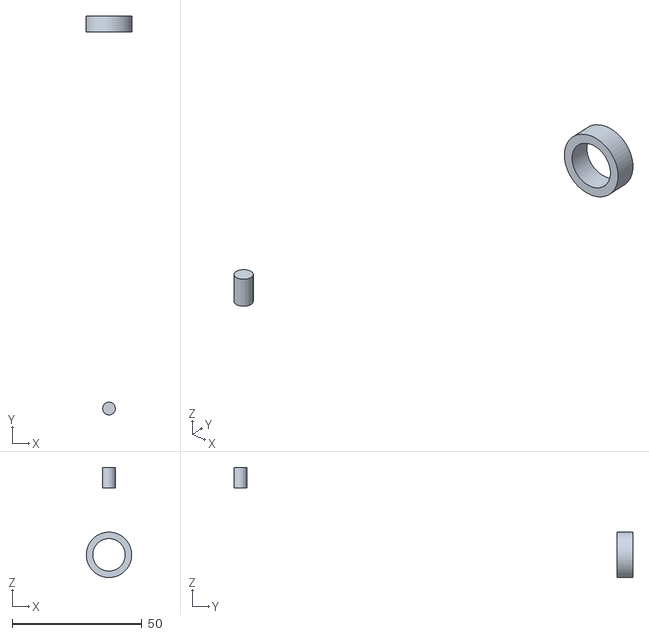
[picture p81: CAD file, 2026-10-21]
docs/viewer/models/L2_rubber.stl
17.5 x 153.6 x 42.4
