rvi007/welding-robot/docs/viewer/models/L1_printed2.stl

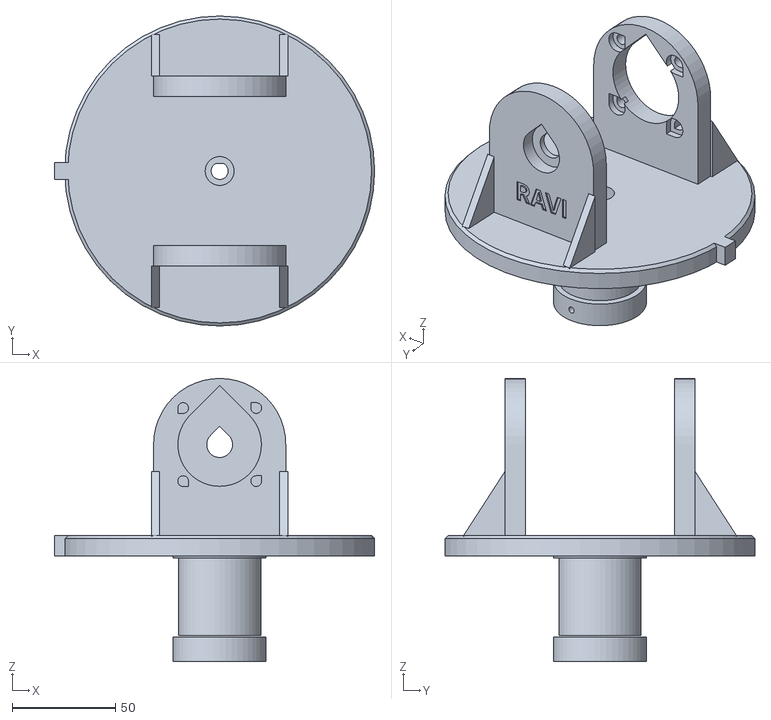
[picture p82: CAD file, 2026-10-21]
docs/viewer/models/L1_printed2.stl
155.0 x 150.0 x 137.0
