rvi007/welding-robot/cad/print/forearm_drive.scad

include <../parts.scad>

print_forearm_drive();
