rvi007/welding-robot/cad/print/forearm_idle.scad

include <../parts.scad>

print_forearm_idle();
