rvi007/welding-robot/cad/print/j1_motor_mount.scad

include <../parts.scad>

print_j1_motor_mount();
