rvi007/welding-robot/cad/print/upper_arm_drive.scad

include <../parts.scad>

print_upper_arm_drive();
