rvi007/welding-robot/cad/print/upper_arm_idle.scad

include <../parts.scad>

print_upper_arm_idle();
