rvi007/welding-robot/cad/print/base_floor.scad

include <../parts.scad>

print_base_floor();
