rvi007/welding-robot/cad/print/base_shell.scad

include <../parts.scad>

print_base_shell();
