rvi007/welding-robot/cad/print/endstop_clip.scad

include <../parts.scad>

print_endstop_clip();
