rvi007/welding-robot/cad/print/fit_test.scad

include <../parts.scad>

print_fit_test();
