rvi007/welding-robot/cad/print/j1_collar.scad

include <../parts.scad>

print_j1_collar();
