rvi007/welding-robot/cad/print/j1_spigot.scad

include <../parts.scad>

print_j1_spigot();
