rvi007/welding-robot/cad/print/j2_cover.scad

include <../parts.scad>

print_j2_cover();
