rvi007/welding-robot/cad/print/j3_cover.scad

include <../parts.scad>

print_j3_cover();
