rvi007/welding-robot/cad/print/spacer_m8.scad

include <../parts.scad>

print_spacer_m8();
