rvi007/welding-robot/cad/print/tool_holder.scad

include <../parts.scad>

print_tool_holder();
