rvi007/welding-robot/cad/print/turntable.scad

include <../parts.scad>

print_turntable();
