rvi007/welding-robot/cad/print/wrist.scad

include <../parts.scad>

print_wrist();
