rvi007/welding-robot/(list of files, cad)

Other CAD files:
docs/viewer/models/L4_rubber.stl
docs/viewer/models/C_gm17_34_rubber.stl
docs/viewer/models/L4_printed.stl
stl/tool_holder.stl
stl/forearm_idle.stl
docs/viewer/models/L3_alu.stl
docs/viewer/models/L3_rubber.stl
docs/viewer/models/L1_printed.stl
docs/viewer/models/C_gm17_48_logo.stl
docs/viewer/models/C_gm17_48_alu.stl
docs/viewer/models/C_gm17_34_alu.stl
docs/viewer/models/C_gm23_56_rubber.stl
docs/viewer/models/L1_alu.stl
docs/viewer/models/C_gm17_34_black.stl
docs/viewer/models/C_gm23_56_black.stl
docs/viewer/models/L2_alu.stl
docs/viewer/models/L4_steel.stl
docs/viewer/models/L0_black.stl
