rvi007/welding-robot/(commit log)

2026-10-21 Ravi WR-1: 3D-printable 5-axis welding robot
    Build plan (3 phases), bill of materials, printing, assembly,
    electronics/firmware, software and safety guides.
    - Ravi.py: main program (plan, reach, torque, pose/fk, home, jog, run,
    grbl settings)
    - robot/: closed-form kinematics, weld path planner with weave and
    torch angles, G93 G-code generator, statics, simulator, serial sender
    - cad/: parametric OpenSCAD parts and assembly; stl/: 15 printable parts
    - jobs/: example pen, fillet, butt and tube weld jobs
    - tests/: 18 pytest tests
    [assembly.scad, base_floor.scad, base_floor.stl, base_shell.scad, base_shell.stl, bom.csv, config.scad, endstop_clip.scad]
2026-10-21 RAVI WR-1 Rev B: realistic parts, motors, renders and per-part catalog
    - Printed parts: RAVI / WR-1 branding (raised on the base, recessed on the
    arm, turntable, forearm and covers), chamfered edges, new push-on J2/J3
    motor covers (17 STLs, 22 pieces)
    - cad/vitamins.scad: detailed NEMA17/NEMA23 steppers with planetary
    gearboxes, shafts, connectors, bearings, bolts and nuts; work cell
    - assembly.scad split into links for rendering and the 3D viewer
    - docs/viewer: interactive three.js viewer with joint sliders and weld
    job playback; realistic renders and weld animation in docs/images
    - docs/PARTS.md: per-part catalog with images, print settings, filament,
    print time and the hardware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
    [C_b6008_rubber.stl, C_b6008_steel.stl, C_b608_rubber.stl, C_b608_steel.stl, C_gm17_34_alu.stl, C_gm17_34_black.stl, C_gm17_34_logo.stl, C_gm17_34_rubber.stl]
